shivamtiwari020505/systolicforge-npu/docs/evidence/vivado/2026-10-14/vivado_basys3/build_manifest.txt

flow=basys3_uart_engine_implementation
top=systolicforge_fpga_uart_demo
part=xc7a35tcpg236-1
board=Digilent_Basys3
array_rows=8
array_cols=8
data_width=8
accumulator_width=32
execution_engine=serialized_scratchpad_prefetch
scratchpad_words_per_memory=128
instruction_words=16
uart_format=115200_8N1
uart_clocks_per_bit=868
clock_period_ns=10.000
route_wns_ns=0.036
route_whs_ns=0.067
instruction_validation=registered_8x16_product_25bit_range_check
row_addressing=incrementing_pointers
control_reset=synchronous_active_low
power_method=vectorless_estimate
vivado_version=2025.2
generated_utc=2026-10-13T18:56:09Z
git_commit=unknown
git_status=unknown
bitstream_generated=true
completed_utc=2026-10-13T18:57:15Z
