shivamtiwari020505/systolicforge-npu/docs/evidence/vivado/2026-10-14/vivado_npu_ooc_full/build_manifest.txt

flow=whole_npu_out_of_context_synthesis
profile=full
top=systolicforge_soc
part=xc7a35tcpg236-1
array_rows=8
array_cols=8
data_width=8
accumulator_width=32
clock_period_ns=10.000
local_address_width=12
scratchpad_words_per_memory=4096
instruction_words=256
execution_engine=scheduled_synchronous_sdp
operand_prefetch=pipelined_active_lanes
activation_row_buffers=2
instruction_validation=registered_8x16_product_25bit_range_check
row_addressing=incrementing_pointers
control_reset=synchronous_active_low
memory_mapping=inferred_block_ram
dissolve_memory_size_limit_bits=tool_default
fit_or_route_claim=none
vivado_version=2025.2
generated_utc=2026-10-13T18:31:53Z
git_commit=unknown
git_status=unknown
inferred_bram_primitives=8
synth_wns_ns=2.098
synth_setup_target_met=1
completed_utc=2026-10-13T18:37:57Z
