shivamtiwari020505/systolicforge-npu/docs/images/npu_instruction_timing.png

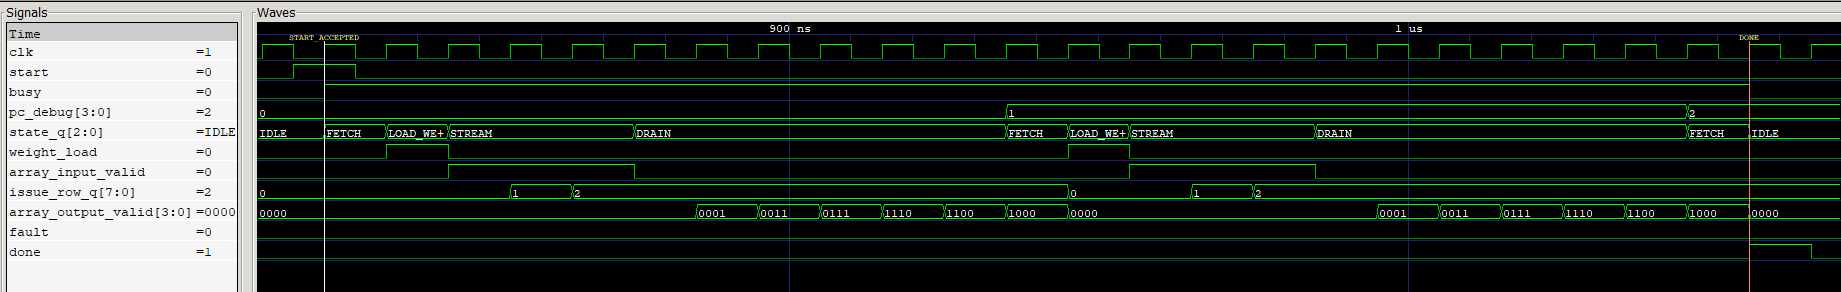
docs/images/npu_instruction_timing.png
