shivamtiwari020505/systolicforge-npu/fpga/basys3/basys3.xdc

## Digilent Basys3, 100 MHz oscillator
set_property CFGBVS VCCO [current_design]
set_property CONFIG_VOLTAGE 3.3 [current_design]

set_property -dict { PACKAGE_PIN W5 IOSTANDARD LVCMOS33 } [get_ports clk]
create_clock -add -name sys_clk -period 10.000 -waveform {0 5.000} [get_ports clk]

## Buttons: BTNU resets, BTNC starts/restarts the self-test
set_property -dict { PACKAGE_PIN T18 IOSTANDARD LVCMOS33 } [get_ports reset_button]
set_property -dict { PACKAGE_PIN U18 IOSTANDARD LVCMOS33 } [get_ports start_button]

## USB-UART bridge: host TX -> FPGA RX, FPGA TX -> host RX
set_property -dict { PACKAGE_PIN B18 IOSTANDARD LVCMOS33 } [get_ports uart_rx]
set_property -dict { PACKAGE_PIN A18 IOSTANDARD LVCMOS33 } [get_ports uart_tx]

## The buttons and UART RX are asynchronous to sys_clk and enter two-stage
## synchronizers in RTL. UART TX and the LEDs have no external capture clock.
set_false_path -from [get_ports {reset_button start_button uart_rx}]
set_false_path -to [get_ports uart_tx]
set_false_path -to [get_ports {leds[*]}]

## User LEDs
set_property -dict { PACKAGE_PIN U16 IOSTANDARD LVCMOS33 } [get_ports {leds[0]}]
set_property -dict { PACKAGE_PIN E19 IOSTANDARD LVCMOS33 } [get_ports {leds[1]}]
set_property -dict { PACKAGE_PIN U19 IOSTANDARD LVCMOS33 } [get_ports {leds[2]}]
set_property -dict { PACKAGE_PIN V19 IOSTANDARD LVCMOS33 } [get_ports {leds[3]}]
set_property -dict { PACKAGE_PIN W18 IOSTANDARD LVCMOS33 } [get_ports {leds[4]}]
set_property -dict { PACKAGE_PIN U15 IOSTANDARD LVCMOS33 } [get_ports {leds[5]}]
set_property -dict { PACKAGE_PIN U14 IOSTANDARD LVCMOS33 } [get_ports {leds[6]}]
set_property -dict { PACKAGE_PIN V14 IOSTANDARD LVCMOS33 } [get_ports {leds[7]}]
set_property -dict { PACKAGE_PIN V13 IOSTANDARD LVCMOS33 } [get_ports {leds[8]}]
set_property -dict { PACKAGE_PIN V3  IOSTANDARD LVCMOS33 } [get_ports {leds[9]}]
set_property -dict { PACKAGE_PIN W3  IOSTANDARD LVCMOS33 } [get_ports {leds[10]}]
set_property -dict { PACKAGE_PIN U3  IOSTANDARD LVCMOS33 } [get_ports {leds[11]}]
set_property -dict { PACKAGE_PIN P3  IOSTANDARD LVCMOS33 } [get_ports {leds[12]}]
set_property -dict { PACKAGE_PIN N3  IOSTANDARD LVCMOS33 } [get_ports {leds[13]}]
set_property -dict { PACKAGE_PIN P1  IOSTANDARD LVCMOS33 } [get_ports {leds[14]}]
set_property -dict { PACKAGE_PIN L1  IOSTANDARD LVCMOS33 } [get_ports {leds[15]}]
