shivamtiwari020505/systolicforge-npu/(commit log)

2026-08-26 Add UART-programmable Basys3 demo
2026-10-14 Close Basys3 FPGA timing and archive Vivado evidence
    [ARCHIVE_SHA256.csv]
2026-10-14 Prepare Basys3 board validation and UART evidence capture
