shivamtiwari020505/systolicforge-npu/(notices)

Notices in the files:
README.md:
License: MIT
